openlab-aux/3d-printer-prusa-i3-1/README.md

# 3d-printer-prusa-i3-2
Config und Firmware für Prusa i3 #1

Anweisungen zur Verwendung des Druckers [im Wiki des OpenLab](https://wiki.openlab-augsburg.de/Prusa%20i3)
