openlab-aux/3d-printer-prusa-i3-1/(list of files, cad)

Other CAD files:
scad/extras/inc/parametric_involute_gear_v5.0.scad
scad/bushing.scad
scad/doc/boxframe.scad
scad/doc/complete-printer-plus.scad
scad/doc/complete-printer.scad
scad/extras/bearing-holder-single-plate-y.scad
scad/extras/calibrate.scad
scad/extras/endstop-holder.scad
scad/extras/foldingclamp.scad
scad/extras/gear-big.scad
scad/extras/groovemount.scad
scad/extras/tube_clamp.scad
scad/inc/bearing-guide.scad
scad/inc/conf_bushing.scad
scad/inc/functions.scad
scad/inc/metric.scad
scad/x-carriage.scad
scad/x-end.scad
scad/y-axis-bracket.scad
scad/y-axis-corner.scad
scad/y-belt-holder.scad
scad/y-drivetrain.scad
scad/z-axis.scad
